FriedYeti/design-project/README.md

# Senior Design Project

All of the finished source code, designs, and documents for my group's Capstone Design Project - An Improved Wireless Dog Fence.

All of the design files and source code are available under the AGPL 3.0 license.
