FriedYeti/design-project/documents/PartsList.xlsx

Parts | Master Post | Slave Post 1 | Slave Post 2 | Controller | Total | SD1522
IC's |  |  |  |  |  | Carl Baumann
PIC18LF4620 | x1 | x1 | x1 | x1 | x4 | Erik Brekkestran
TRM-418-LT | x1 | x1 | x1 | x1 | x4 | Cooper Willis
MCP604 | x1 | x1 | x1 | x1 | x4
Resistors
10 Ohm | x1 | x1 | x1 | x1 | x4
100 Ohm | x2 | x2 | x2 |  | x6
470 Ohm | x1 | x1 | x1 | x1 | x4
1 kOhm | x2 | x4 | x4 | x6 | x16
10 kOhm |  | x4 | x4 | x1 | x9
47 kOhm |  | x1 | x1 | x1 | x3
120 kOhm |  | x1 | x1 |  | x2
470 kOhm |  | x1 | x1 | x1 | x3
2 MOhm |  | x2 | x2 | x2 | x6
3 MOhm |  | x1 | x1 | x1 | x3
Capacitators
22 pF | x2 | x2 | x2 | x2 | x8
820 pF |  | x1 | x1 | x1 | x3
10 nF |  | x1 | x1 | x1 | x3
100 nF |  | x2 | x2 | x2 | x6
10 uF | x1 | x1 | x1 | x1 | x4
Diodes
Red LED |  | x1 | x1 | x1 | x3
Yellow LED |  | x1 | x1 |  | x2
Green LED |  |  |  | x1 | x1
Si |  | x1 | x1 |  | x2
Ge |  | x1 | x1 |  | x2
Misc.
40 Pin Socket | x1 | x1 | x1 | x1 | x4
6 Pin Header | x2 | x2 | x2 | x2 | x8
2 Pin Header | x1 | x1 | x1 | x1 | x4
ANT-418-HETH | x1 | x1 | x1 | x1 | x4
Buttons | x1 | x1 | x1 | x3 | x6
10 MHz Crystal | x1 | x1 | x1 | x1 | x4
Switch | x1 | x1 | x1 | x1 | x4
ZVN2106A |  | x1 | x1 |  | x2
