FriedYeti/design-project/(list of files, cad)

Other CAD files:
hardware/Enclosure.blend
