FriedYeti/design-project/documents/User_Manual.docx

Improved Wireless Dog Fence

User Manual

SD1522

Carl Baumann, Erik Brekkestran, and Cooper Willis

# User Manual

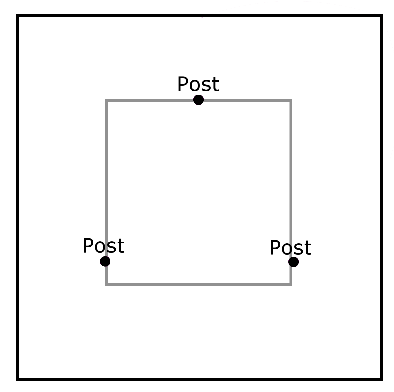
[picture p21: figure]

# Post Placement

Posts should be placed inside the border, around the thirds region (see Figure 1 for an example).

*Note – posts should be about 3 feet off the ground

# Building a border

1. Ensure all posts are powered before attempting

Figure 1: The grey outline is the thirds region, and the black outline is the desired region

2. Press the button labeled “Distances”, the light will start flickering
3. Add a point at each corner by holding the controller at each point and pressing the button labeled “Border Points.” The light will turn off until it is finished storing the data and will then flash the light to notify how many border points have been set.
4. Once you have set all points, press the button labeled “Distances” to exit the border building

# Testing the border

If the controller is not in build mode, it will constantly check if it is inside the border (at a rate of about once every two seconds). If the light flashes, the controller is outside the border, but if it isn’t flashing, then it is inside the border.

# Replacing Batteries

## Posts

The posts each have 2x C cell batteries. To replace them, remove the cover, take the battery holder out of the enclosure, and swap the batteries

## Collar/Handheld Unit

The collar/handheld unit has 2x CR123 batteries. To replace them, remove the cover, take the battery holder out of the enclosure, and swap the batteries.
