FriedYeti/design-project/(list of files, drawings)

Other design files:
hardware/Final_PCBs-with_post_mortem/MasterPost.fzz
hardware/Final_PCBs-with_post_mortem/SlavePost.fzz
hardware/Final_PCBs-with_post_mortem/WirelessController.fzz
